SamWibatt/FPGA_HD44780/images/HD44780BusTimingdiagram.jpg

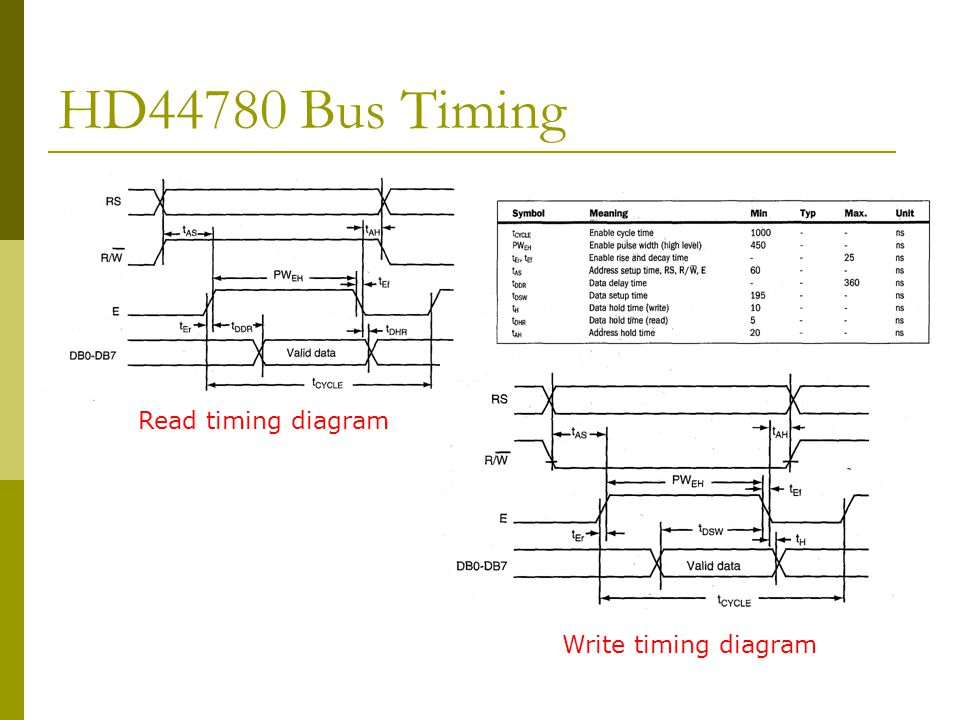
images/HD44780BusTimingdiagram.jpg
