SamWibatt/FPGA_HD44780/settings/HelloTest.csv

Time[s] | LCDData0 | LCDData1 | LCDData2 | LCDData3 | LCDRS | LCDE | LogAnStb
-0.007812530 | 0 | 0 | 0 | 0 | 0 | 0 | 0
0.000000000 | 0 | 0 | 0 | 0 | 0 | 0 | 1
0.000001156 | 1 | 1 | 0 | 0 | 0 | 0 | 1
0.000001469 | 1 | 1 | 0 | 0 | 0 | 1 | 1
0.000001969 | 1 | 1 | 0 | 0 | 0 | 0 | 1
0.004052437 | 1 | 1 | 0 | 0 | 0 | 1 | 1
0.004052938 | 1 | 1 | 0 | 0 | 0 | 0 | 1
0.004154469 | 1 | 1 | 0 | 0 | 0 | 1 | 1
0.004154969 | 1 | 1 | 0 | 0 | 0 | 0 | 1
0.004256188 | 0 | 1 | 0 | 0 | 0 | 0 | 1
0.004256531 | 0 | 1 | 0 | 0 | 0 | 1 | 1
0.004257000 | 0 | 1 | 0 | 0 | 0 | 0 | 1
0.004358531 | 0 | 1 | 0 | 0 | 0 | 1 | 1
0.004359031 | 0 | 1 | 0 | 0 | 0 | 0 | 1
0.004360344 | 0 | 0 | 0 | 1 | 0 | 0 | 1
0.004360656 | 0 | 0 | 0 | 1 | 0 | 1 | 1
0.004361156 | 0 | 0 | 0 | 1 | 0 | 0 | 1
0.004415969 | 0 | 0 | 0 | 0 | 0 | 0 | 1
0.004416281 | 0 | 0 | 0 | 0 | 0 | 1 | 1
0.004416781 | 0 | 0 | 0 | 0 | 0 | 0 | 1
0.004418094 | 0 | 0 | 0 | 1 | 0 | 0 | 1
0.004418438 | 0 | 0 | 0 | 1 | 0 | 1 | 1
0.004418906 | 0 | 0 | 0 | 1 | 0 | 0 | 1
0.004473719 | 0 | 0 | 0 | 0 | 0 | 0 | 1
0.004474031 | 0 | 0 | 0 | 0 | 0 | 1 | 1
0.004474531 | 0 | 0 | 0 | 0 | 0 | 0 | 1
0.004475844 | 1 | 0 | 0 | 0 | 0 | 0 | 1
0.004476188 | 1 | 0 | 0 | 0 | 0 | 1 | 1
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
