SamWibatt/FPGA_HD44780/settings/HelloTest5V.csv

Time[s] | LCDData0 | LCDData1 | LCDData2 | LCDData3 | LCDRS | LCDE | LogAnStb
-0.007812687 | 0 | 0 | 0 | 0 | 0 | 0 | 0
0.000000000 | 0 | 0 | 0 | 0 | 0 | 0 | 1
0.000001156 | 1 | 1 | 0 | 0 | 0 | 0 | 1
0.000001469 | 1 | 1 | 0 | 0 | 0 | 1 | 1
0.000001969 | 1 | 1 | 0 | 0 | 0 | 0 | 1
0.004059594 | 1 | 1 | 0 | 0 | 0 | 1 | 1
0.004060094 | 1 | 1 | 0 | 0 | 0 | 0 | 1
0.004161781 | 1 | 1 | 0 | 0 | 0 | 1 | 1
0.004162281 | 1 | 1 | 0 | 0 | 0 | 0 | 1
0.004263656 | 0 | 1 | 0 | 0 | 0 | 0 | 1
0.004263969 | 0 | 1 | 0 | 0 | 0 | 1 | 1
0.004264469 | 0 | 1 | 0 | 0 | 0 | 0 | 1
0.004366156 | 0 | 1 | 0 | 0 | 0 | 1 | 1
0.004366656 | 0 | 1 | 0 | 0 | 0 | 0 | 1
0.004367969 | 0 | 0 | 0 | 1 | 0 | 0 | 1
0.004368313 | 0 | 0 | 0 | 1 | 0 | 1 | 1
0.004368812 | 0 | 0 | 0 | 1 | 0 | 0 | 1
0.004423688 | 0 | 0 | 0 | 0 | 0 | 0 | 1
0.004424000 | 0 | 0 | 0 | 0 | 0 | 1 | 1
0.004424500 | 0 | 0 | 0 | 0 | 0 | 0 | 1
0.004425813 | 0 | 0 | 0 | 1 | 0 | 0 | 1
0.004426156 | 0 | 0 | 0 | 1 | 0 | 1 | 1
0.004426656 | 0 | 0 | 0 | 1 | 0 | 0 | 1
0.004481531 | 0 | 0 | 0 | 0 | 0 | 0 | 1
0.004481844 | 0 | 0 | 0 | 0 | 0 | 1 | 1
0.004482344 | 0 | 0 | 0 | 0 | 0 | 0 | 1
0.004483688 | 1 | 0 | 0 | 0 | 0 | 0 | 1
0.004484000 | 1 | 0 | 0 | 0 | 0 | 1 | 1
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
