SamWibatt/FPGA_HD44780/settings/HelloTestLong.csv

Time[s] | LCDData0 | LCDData1 | LCDData2 | LCDData3 | LCDRS | LCDE | LogAnStb
-0.031250062 | 0 | 0 | 0 | 0 | 0 | 0 | 0
0.000000000 | 0 | 0 | 0 | 0 | 0 | 0 | 1
0.000001156 | 1 | 1 | 0 | 0 | 0 | 0 | 1
0.000001469 | 1 | 1 | 0 | 0 | 0 | 1 | 1
0.000001969 | 1 | 1 | 0 | 0 | 0 | 0 | 1
0.004053187 | 1 | 1 | 0 | 0 | 0 | 1 | 1
0.004053688 | 1 | 1 | 0 | 0 | 0 | 0 | 1
0.004155188 | 1 | 1 | 0 | 0 | 0 | 1 | 1
0.004155687 | 1 | 1 | 0 | 0 | 0 | 0 | 1
0.004256906 | 0 | 1 | 0 | 0 | 0 | 0 | 1
0.004257250 | 0 | 1 | 0 | 0 | 0 | 1 | 1
0.004257719 | 0 | 1 | 0 | 0 | 0 | 0 | 1
0.004359250 | 0 | 1 | 0 | 0 | 0 | 1 | 1
0.004359750 | 0 | 1 | 0 | 0 | 0 | 0 | 1
0.004361062 | 0 | 0 | 0 | 1 | 0 | 0 | 1
0.004361406 | 0 | 0 | 0 | 1 | 0 | 1 | 1
0.004361906 | 0 | 0 | 0 | 1 | 0 | 0 | 1
0.004416688 | 0 | 0 | 0 | 0 | 0 | 0 | 1
0.004417031 | 0 | 0 | 0 | 0 | 0 | 1 | 1
0.004417531 | 0 | 0 | 0 | 0 | 0 | 0 | 1
0.004418844 | 0 | 0 | 0 | 1 | 0 | 0 | 1
0.004419156 | 0 | 0 | 0 | 1 | 0 | 1 | 1
0.004419656 | 0 | 0 | 0 | 1 | 0 | 0 | 1
0.004474469 | 0 | 0 | 0 | 0 | 0 | 0 | 1
0.004474813 | 0 | 0 | 0 | 0 | 0 | 1 | 1
0.004475281 | 0 | 0 | 0 | 0 | 0 | 0 | 1
0.004476625 | 1 | 0 | 0 | 0 | 0 | 0 | 1
0.004476938 | 1 | 0 | 0 | 0 | 0 | 1 | 1
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
