SamWibatt/FPGA_HD44780/(threads)

Thread 39 (2019-10-31):

build 3.3V PMOD LCD adapter with TL7660 contrast fiddler

SamWibatt, 2019-10-31:

SamWibatt, 2019-11-02:
Find one of my 4x20s with a backlight and add a transistor-switched backlight pin. Would it be possible to use the 3.3V as its voltage and the negative contrast voltage as its ground? Could run lower current that way, plus I don't know what transistor to use to switch 3.3V signals.
