SamWibatt/FPGA_HD44780/images/FPGA_HD44780_Hello.sch

## KiCad design images/FPGA_HD44780_Hello.sch (2019-10-27)

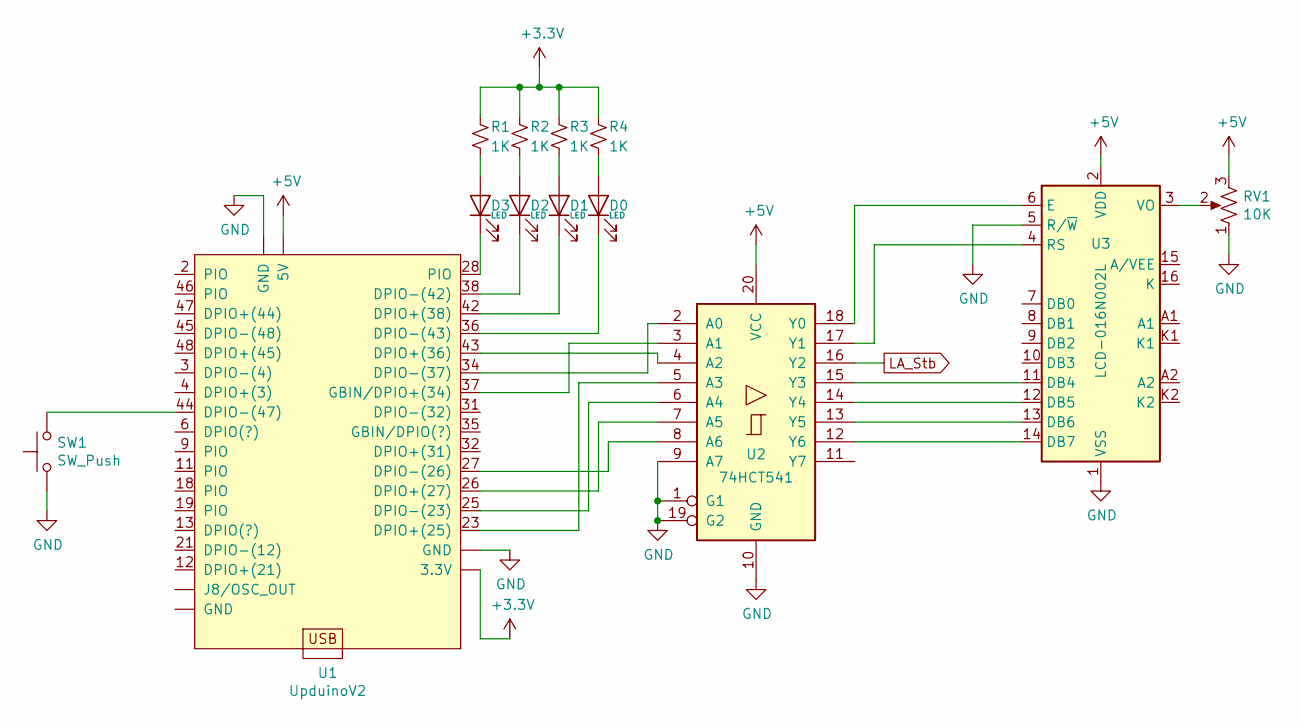
[picture p4: schematic FPGA_HD44780_Hello.sch]

Parts:
D0, D1, D2, D3: LED
R1, R2, R3, R4: 1K
RV1: 10K
SW1: SW_Push
U1: UpduinoV2
U2: 74HCT541
U3: LCD-016N002L

Connections:
+3.3V: R1.1, R2.1, R3.1, R4.1, U1.~ (3.3V)
+5V: RV1.3, U1.~ (3.3V), U2.20 (VCC), U3.2 (VDD)
GND: RV1.1, SW1.1, U1.~ (3.3V), U2.1 (G1), U2.9 (A7), U2.10 (GND), U2.19 (G2), U3.1 (VSS), U3.5 (R/~W)
LA_Stb: U2.16 (Y2)
unnamed: D0.1 (K), U1.36 (DPIO-(43))
unnamed: D0.2 (A), R4.2
unnamed: D1.1 (K), U1.42 (DPIO+(38))
unnamed: D1.2 (A), R3.2
unnamed: D2.1 (K), U1.38 (DPIO-(42))
unnamed: D2.2 (A), R2.2
unnamed: D3.1 (K), U1.28 (PIO)
unnamed: D3.2 (A), R1.2
unnamed: RV1.2, U3.3 (VO)
unnamed: SW1.2, U1.44 (DPIO-(47))
unnamed: U1.23 (DPIO+(25)), U2.5 (A3)
unnamed: U1.25 (DPIO-(23)), U2.6 (A4)
unnamed: U1.26 (DPIO+(27)), U2.7 (A5)
unnamed: U1.27 (DPIO-(26)), U2.8 (A6)
unnamed: U1.34 (DPIO-(37)), U2.2 (A0)
unnamed: U1.37 (GBIN/DPIO+(34)), U2.3 (A1)
unnamed: U1.43 (DPIO+(36)), U2.4 (A2)
unnamed: U2.12 (Y6), U3.14 (DB7)
unnamed: U2.13 (Y5), U3.13 (DB6)
unnamed: U2.14 (Y4), U3.12 (DB5)
unnamed: U2.15 (Y3), U3.11 (DB4)
unnamed: U2.17 (Y1), U3.4 (RS)
unnamed: U2.18 (Y0), U3.6 (E)
