SamWibatt/FPGA_HD44780/images/FPGA_HD44780_Hello_3V3.sch

## KiCad design images/FPGA_HD44780_Hello_3V3.sch (2019-11-11)

Schematic: FPGA_HD44780_Hello_3V3.sch

Parts:
C1, C2: 10uF
D0, D1, D2, D3: LED
R1, R2, R3, R4: 1K
RV1: 10K
SW1: SW_Push
U1: UpduinoV2
U2: TL7660
U3: LCD-016N002L
