SamWibatt/FPGA_HD44780/(commit log)

2019-08-22 state timer tweak
2019-08-22 working on LCD timer
2019-08-22 attempt figure out LCD timer bits automatically
2019-08-22 moved lcd state timer to controller
2019-08-28 broken bc yosys doesn't like fancy defines
    [hd44780_controller.v]
2019-08-29 successful sim tb for timer
2019-08-29 fixed clock signal to state timer tb
    [hd44780_controller.v, hd44780_tb.v]
2019-08-29 poss fix for 1 bit ctr bug in nsend tb
    [hd44780_config.py]
2019-08-31 broke out goal 1 testbench
    [hd44780_timer_tb.v]
2019-09-12 second strobe shows broken in cont tb
    [hd44780_tb.v]
2019-09-13 state enum, nybble order fixed
    [hd44780_controller.v]
2019-09-13 separated nybsen and timer from cont
2019-09-17 All LEDs blink
2019-09-17 top all LEDs & btn, should be ready for LA
2019-09-20 version with 1st worky la build ctrlr
2019-09-21 Timer HW test 1
    [TimerLATest.csv]
2019-09-21 timer la test 2
    [TimerLATest.csv]
2019-09-21 timer la test 3
2019-09-22 timer test now build.sh timer
2019-09-25 kvis2vcd col name bugfix
    [kvis2vcd.py]
2019-09-28 build.sh timer,nybsen,bytesen compile
2019-09-28 build/sim timer,nybsen,bytesen compile
2019-09-28 bytesen hw test
    [BytesenTop01.csv]
2019-09-28 nybsen hw test
    [NybsenTop.csv]
2019-09-29 sim ctrlr minimally works, build ctrlr doesn't
    [hd44780_controller.v, hd44780_controller_tb.v, hd44780_ram.v]
2019-09-30 ram hw test workyish swap cable n see
    [RamTest01.csv]
2019-10-15 timer refactor end strobe to busy
2019-10-16 Arduino test sketch
2019-10-16 arduino comment
2019-10-21 first hello LA sample
    [HelloTest.csv, HelloTestLong.csv]
2019-10-21 LA I think it works!
    [HelloTest.csv, HelloTestLong.csv]
2019-10-23 LA 5V test w hct541
    [HelloTest5V.csv]
2019-10-27 init kicad sch and upduino part
    [FPGA_HD44780_Hello.sch]
2019-10-27 test circuit schematic
    [FPGA_HD44780_Hello.sch]
2019-11-11 schematic with -3.3V
    [FPGA_HD44780_Hello_3V3.sch]
